romancieciuch/alarm-domowy/README.md

# Alarm domowy
Alarm domowy z wykorzystaniem Arduino UNO.

## Licencja
Creative Commons Zero (CC0)

## Projekt w Wokwi
<https://wokwi.com/projects/463992320389011457>

## Zawartość repozytorium
- **Kod programu** - pliki źródłowe
- **Instrukcja** - pliki z instrukcją jak odtworzyć projekt krok po kroku
- **Obrazki** - zrzuty ekranu użyte do stworzenia instrukcji
- **Wideo** - film oprowadzający po projekcie

## Film oprowadzający po projekcie
<https://youtu.be/s39St69Hleg>

## Gotowy system
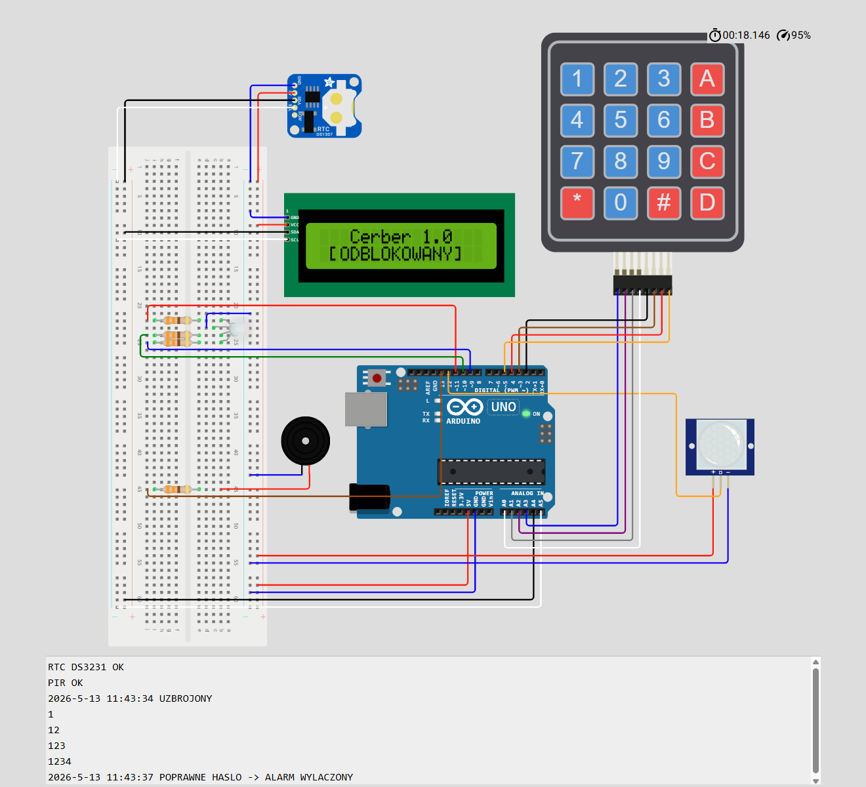
[picture p1: Obrazki/09-system.png]
Alarm domowy


## Lista zakupów
| Element | Model | Funkcja | Ilość sztuk |
|---|---|---|---|
| Arduino | UNO lub zamiennik | Sterownik główny | 1 |
| PIR | HC-SR501 | Detekcja ruchu | 1 |
| RTC | DS1307 / DS3231 | Data i godzina | 1 |
| LCD | 1602 I2C | Interfejs użytkownika | 1 |
| Dioda RGB LED | wspólna katoda | Sygnalizacja stanu | 1 |
| Keypad | 4x4 | Wprowadzanie danych | 1 |
| EEPROM | wbudowany w płytkę Arduino | Przechowywanie danych pomimo utraty zasilania | 1 |
| Rezystory | 330 Om | Ochrona przed spaleniem komponentów | 4 |
| Buzzer | buzzer z generatorem 5V 12mm - THT | Dźwięki alarmu | 1 |
| Płytka stykowa | Duża | Połączenie elementów w układ | 1 |
| Kable połączeniowe | Różne długości, wejścia męsko – męskie, męsko - żeńskie | Połączenia elektryczne pomiędzy elementami układu | 1 |

## Zdjęcia z fizycznego projektu
Do końca tygodnia będą
